KamilRosinski/autko/pcb/bom.xlsx

# | Reference | Min qty | Value | Manufacturer | Product | Package | URL | Unit price | Quantity | Total price
1 | BT1 | 1 | n/a | Keystone | 2481RB | custom | https://www.tme.eu/pl/details/keys2481rb/baterie-pojemniki-i-uchwyty/keystone/2481rb/
2 | C1, C5, C9, C11, C12, C13, C14, C16, C17, C19, C20, C22, C23, C24, C26, C27 | 16 | 100nF | Kemet | C0805C104K3RACTU | 0805 | https://www.mouser.pl/ProductDetail/80-C0805C104K3R
3 | C2 | 1 | 47µF, 16V, 40mΩ | Kemet | T521V476M016ATE040 | V | https://www.mouser.pl/ProductDetail/80-T521V476M16ATE40
4 | C3, C4 | 2 | 33µF, 25V, 25mΩ | Kemet | T521V336M025ATE025 | V | https://www.mouser.pl/ProductDetail/80-T521V336M25E25
5 | C6 | 1 | 2.2nF | Kemet | C0805C222K3RACTU | 0805 | https://www.mouser.pl/ProductDetail/80-C0805C222K3R
6 | C7 | 1 | 100pF | Kemet | C0805C101K3RACTU | 0805 | https://www.mouser.pl/ProductDetail/80-C0805C101K3RACTU
7 | C8 | 1 | 330nF | Kemet | C0805C334K3RACTU | 0805 | https://www.mouser.pl/ProductDetail/80-C0805C334K3R
8 | C10, C18 | 2 | 30pF | Kemet | C0805C300K3HACTU | 0805 | https://www.mouser.pl/ProductDetail/80-C0805C300K3HACTU
9 | C15, C21, C25 | 3 | 10uF, 25V, 60mΩ | Kemet | T521T106M025ATE060 | T | https://www.mouser.pl/ProductDetail/80-T521T106M025ATE60
10 | D1 | 1 | n/a | Diotec | SL52-3G | SMB | https://www.mouser.pl/ProductDetail/637-SL52-3G
11 | D2 | 1 | SL1A | Diotec | S1A | SMA | https://www.mouser.pl/ProductDetail/637-S1A
12 | D3, D4 | 2 | GREEN | Kingbright | APT2012LZGCK | 0805 | https://www.mouser.pl/ProductDetail/604-APT2012LZGCK
13 | D5, D6, D7, D8, D9, D10, D11 | 7 | ORANGE | Kingbright | APT2012LSECK/J4-PRV | 0805 | https://www.mouser.pl/ProductDetail/604-APT2012LSECKJ4RV
14 | D12 | 1 | BLUE | Kingbright | APT2012LVBC/D | 0805 | https://www.mouser.pl/ProductDetail/604-APT2012LVBCD
15 | F1 | 1 | 2A | Littlefuse | 1812L200/16DR | 1812 | https://www.mouser.pl/ProductDetail/576-1812L200-16DR
16 | FB1 | 1 | 220Ω | Murata | BLM21BB221SN1D | 0805 | https://www.mouser.pl/ProductDetail/81-BLM21B221S
17 | J1 | 1 | n/a | Molex | 87834-0619 | 2x3, 2.54mm | https://www.mouser.pl/ProductDetail/538-87834-0619
18 | JP1, JP2 | 2 | n/a | Molex | 10-97-7086 | 2x4, 2.54mm | https://www.mouser.pl/ProductDetail/538-10-97-7086
19 | L1 | 1 | 3.3µH | Coilcraft | MSS1260-332NLB | 4747 | https://www.mouser.pl/ProductDetail/994-MSS1260-332NLB
20 | M1, M2 | 2 | n/a | Pololu | Micro DC MP 30:1 | custom | https://www.tme.eu/pl/details/pololu-2364/silniki-dc/pololu/30-1-micro-metal-gearmotor-mp/
21 | Q1 | 1 | n/a | Vishay | Si368DY | SO-8 | https://www.mouser.pl/ProductDetail/781-SI4368DY-T1-E3
22 | R1 | 1 | 1MΩ | Vishay | CRCW08051M00FKEA | 0805 | https://www.mouser.pl/ProductDetail/71-CRCW0805-1.0M-E3
23 | R5 | 1 | 10.2kΩ, 1% | Vishay | CRCW080510K2FKEA | 0805 | https://www.mouser.pl/ProductDetail/71-CRCW0805-10.2K-E3
24 | R3 | 1 | 18kΩ | Vishay | CRCW080518K0FKEA | 0805 | https://www.mouser.pl/ProductDetail/71-CRCW080518K0FKEA
25 | R2 | 1 | 53.6kΩ, 1% | Vishay | CRCW080553K6FKEA | 0805 | https://www.mouser.pl/ProductDetail/71-CRCW080553K6FKEA
26 | R4 | 1 | 20mΩ, 0.5W, 1% | Vishay | WFC0805R0200FE66 | 0805 | https://www.mouser.pl/ProductDetail/71-WFC0805R0200FE66
27 | R6 | 1 | 5.1kΩ | Vishay | CRCW08055K10FKEA | 0805 | https://www.mouser.pl/ProductDetail/71-CRCW0805-5.1K-E3
28 | R7 | 1 | 820Ω | Vishay | CRCW0805820RFKEA | 0805 | https://www.mouser.pl/ProductDetail/71-CRCW0805-820-E3
29 | R8, R9, R12, R13, R14, R36, R37, R38, R39, R40 | 10 | 10kΩ, 0.125W, 1% | Vishay | CRCW080510K0FKEA | 0805 | https://www.mouser.pl/ProductDetail/71-CRCW0805-10K-E3
31 | R10, R11 | 2 | 1kΩ | Vishay | CRCW08051K00FKEA | 0805 | https://www.mouser.pl/ProductDetail/71-CRCW0805-1.0K-E3
32 | R23, R25, R27, R29, R31, R33, R35 | 7 | 20kΩ | Vishay | CRCW080520K0FKEA | 0805 | https://www.mouser.pl/ProductDetail/71-CRCW0805-20K-E3
33 | R15, R16, R17, R18, R19, R20, R21 | 7 | 680Ω | Vishay | CRCW0805680RFKEA | 0805 | https://www.mouser.pl/ProductDetail/71-CRCW0805680RFKEA
34 | R22, R24, R26, R28, R30, R32, R34 | 7 | 220Ω | Vishay | CRCW0805220RFKEA | 0805 | https://www.mouser.pl/ProductDetail/71-CRCW0805-220-E3
35 | R41 | 1 | 100Ω | Vishay | CRCW0805100RFKEA | 0805 | https://www.mouser.pl/ProductDetail/71-CRCW0805-100-E3
36 | R42, R43 | 2 | 330Ω | Vishay | CRCW0805330RFKEA | 0805 | https://www.mouser.pl/ProductDetail/71-CRCW0805-330-E3
37 | SW1 | 1 | n/a | Knitter-switch | MSS 3112 D | custom | https://www.tme.eu/pl/details/mss3112d/przelaczniki-suwakowe/knitter-switch/mss-3112-d/
38 | SW2, SW3 | 2 | n/a | C&K | PTS125SM43LFS | 12mm | https://www.mouser.pl/ProductDetail/611-PTS125SM43-LFS
39 | TP3, TP4, TP5 | 3 | n/a | Kaystone | 5019 | custom | https://www.mouser.pl/ProductDetail/534-5019
40 | U1 | 1 | n/a | Analog Devices | LTC3872 | SOT-23-8 | https://www.mouser.pl/ProductDetail/584-C3872ITS8-1TMPF
41 | U2 | 1 | n/a | TI | UA78M05CDCY | SOT-223-3 | https://www.mouser.pl/ProductDetail/595-UA78M33CDCYRG3
42 | U3 | 1 | n/a | Microchip | ATxmega16A4U | TQFP-44 | https://www.mouser.pl/ProductDetail/Microchip-Technology/ATXMEGA16A4U-AU?qs=HbI%2FMOA3e17KRz9K62%252BJzQ%3D%3D
43 | U4, U5, U6, U7, U8, U9, U10 | 7 | n/a | Vishay | CNY70 | custom | https://www.tme.eu/pl/en/details/cny70/pcb-photoelectric-sensors/vishay/
44 | U11 | 1 | n/a | Toshiba | TB6612FNG | SSOP24 | https://www.tme.eu/pl/en/details/tb6612fng/motor-and-pwm-drivers/toshiba/tb6612fng-o-c-8-el/
45 | U12, U13 | 2 | n/a | Nexperia | 74HC2G14GW | SOT363 | https://www.tme.eu/pl/en/details/74hc2g14gw.125/gates-inverters/nexperia/74hc2g14gw-125/
46 | U14 | 1 | n/a | Microchip | RN4678 | custom | https://www.tme.eu/pl/en/details/rn4678-v_rm113/iot-wifi-bluetooth-modules/microchip-technology/
47 | X1 | 1 | 8MHz, 20pF | Vishay | XT9S20ANA8M | HC-49/US | https://www.mouser.pl/ProductDetail/73-XT49S800-20
48 | n/a | 1 | n/a | Pololu | Metal ball caster 3/8” | custom | https://www.tme.eu/pl/details/pololu-951/akcesoria-do-robotyki-i-rc/pololu/ball-caster-with-3-8-metal-ball/
49 | n/a | 1 | n/a | Pololu | Wheel 32x7 mm black pair | custom | https://www.tme.eu/pl/details/pololu-1087/akcesoria-do-robotyki-i-rc/pololu/pololu-wheel-32x7mm-pair-black/
50 | n/a | 1 | n/a | Pololu | Bracket, black, pair | custom | https://www.tme.eu/pl/details/pololu-989/akcesoria-do-mikrosilnikow/pololu/
