KamilRosinski/autko/pcb/Autko.kicad_pcb

## KiCad design pcb/Autko.kicad_pcb (2024-03-24)

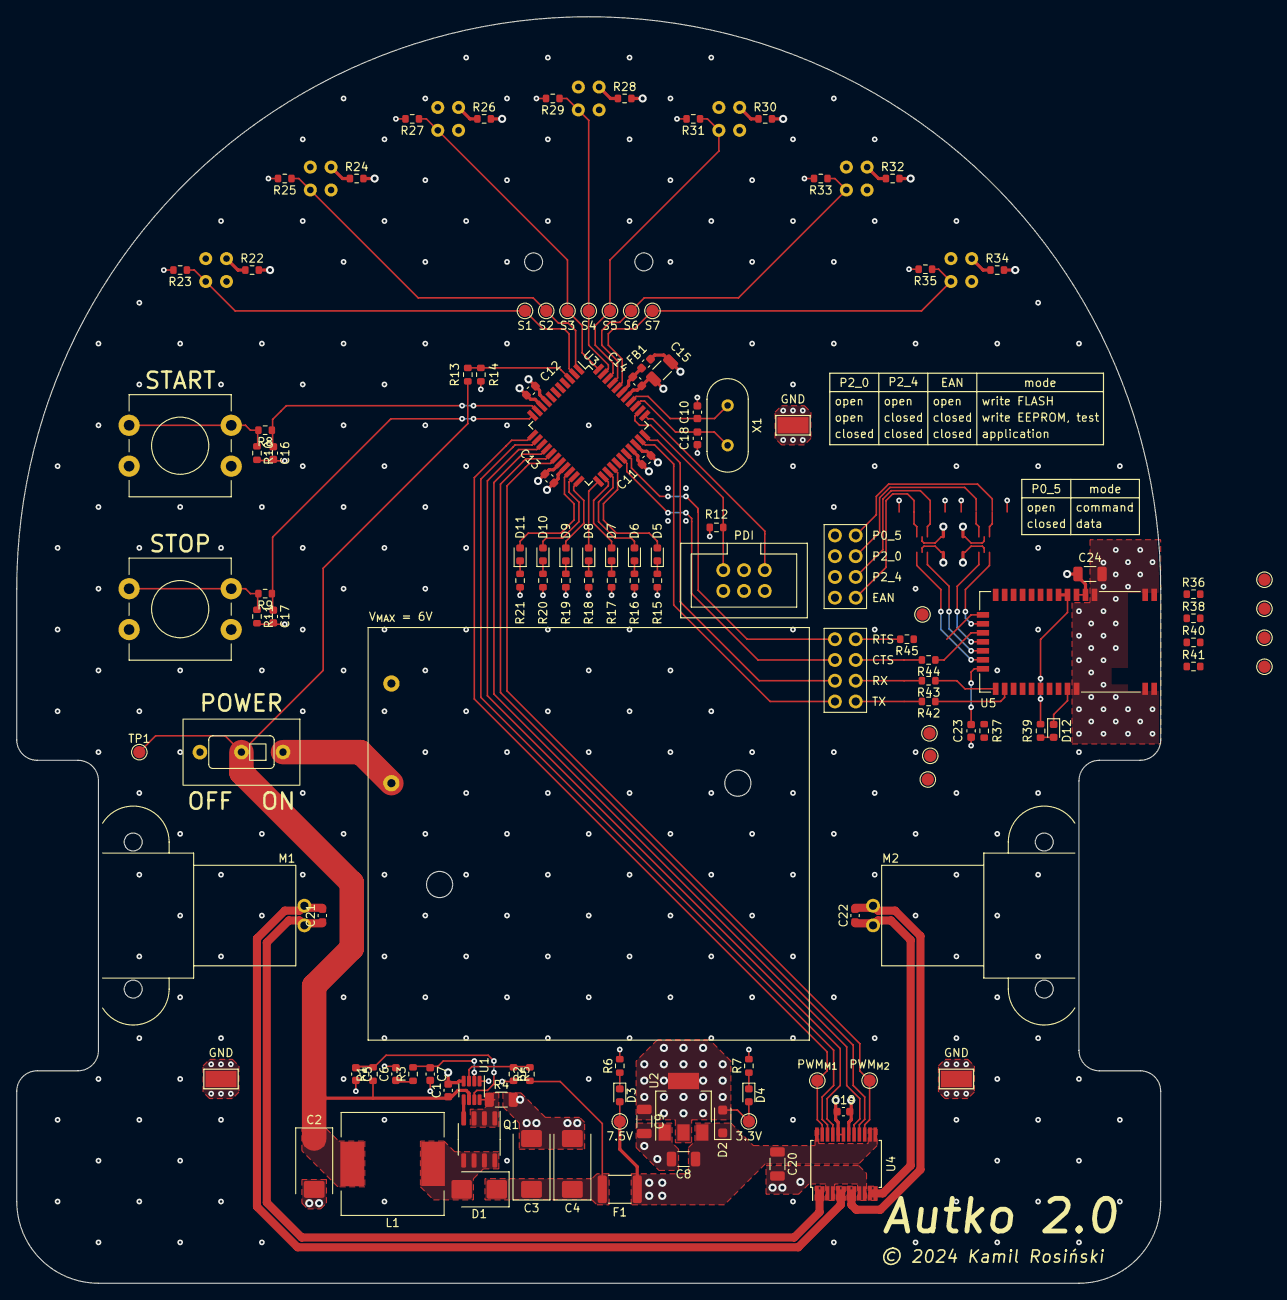
[picture p1: board Autko.kicad_pcb from above]

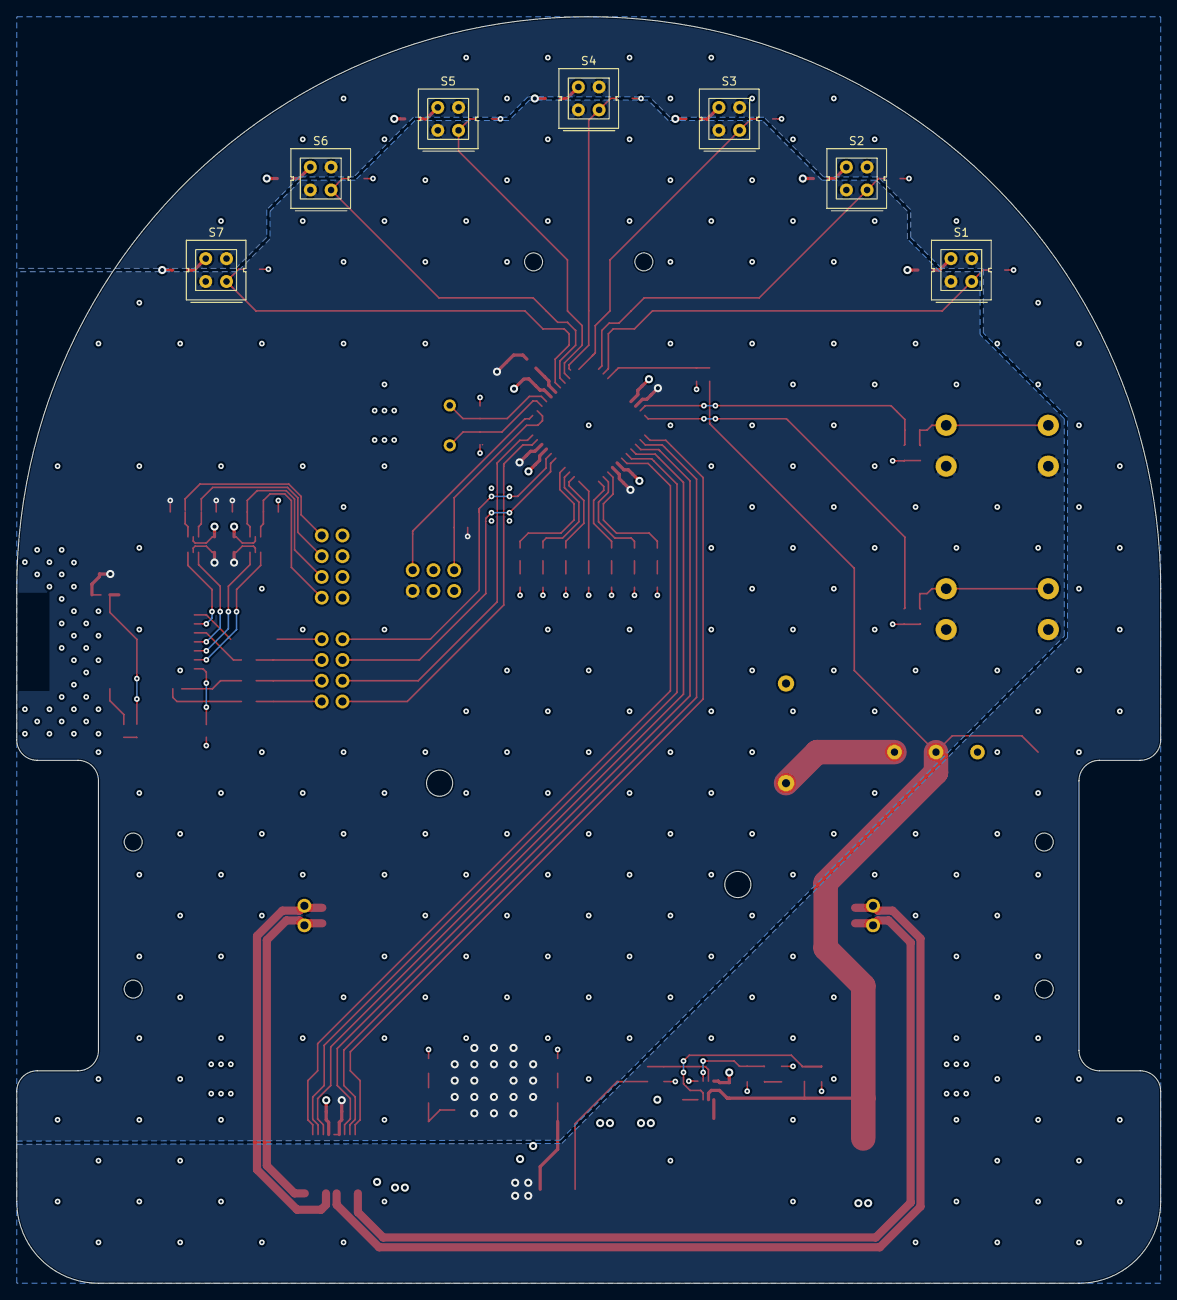
[picture p2: board Autko.kicad_pcb from below]

Board: 4 copper layers, 140.0 x 155.0 mm, 130 parts (7 on the bottom side), 87 nets.

Parts:
BT1: 4xAA; Keystone_2481RB
C1, C5, C11, C12, C13, C14, C16, C17, C19, C21, C22, C23: 100nF; C_0603_1608Metric
C2: 47uF; CP_EIA-7343-20_Kemet-V
C3, C4: 33uF; CP_EIA-7343-20_Kemet-V
C6: 2.2nF; C_0603_1608Metric
C7: 100pF; C_0603_1608Metric
C8: 1uF; C_1206_3216Metric
C9, C15, C20, C24: 10uF; C_1206_3216Metric
C10, C18: 30pF; C_0603_1608Metric
D1: SL52-3G; D_SMB
D2: SL1A; D_SOD-123F
D3, D4: GREEN; LED_0603_1608Metric
D5, D6, D7, D8, D9, D10, D11: ORANGE; LED_0603_1608Metric
D12: BLUE; LED_0603_1608Metric
F1: 2A; Fuse_1812_4532Metric
FB1: 220R; C_0603_1608Metric
J1: PDI; IDC-Header_2x03_P2.54mm_Vertical
JP1, JP2: Jumper_x4_Bridged; PinHeader_2x04_P2.54mm_Vertical
L1: 3.3uH; L_12x12mm_H6mm
M1: LEFT; Pololu_DC_micro
M2: RIGHT; Pololu_DC_micro
Q1: SO-8_3.9x4.9mm_P1.27mm
R1: 1MR; R_0603_1608Metric
R2: 53.6kR; R_0603_1608Metric
R3: 18kR; R_0603_1608Metric
R4: 20mR; R_1206_3216Metric
R5: 10.2kR; R_0603_1608Metric
R6: 5.1kR; R_0603_1608Metric
R7: 820R; R_0603_1608Metric
R8, R9, R12, R13, R14, R37: 10kR; R_0603_1608Metric
R10, R11, R42, R43, R44, R45: 1kR; R_0603_1608Metric
R15, R16, R17, R18, R19, R20, R21: 680R; R_0603_1608Metric
R22, R24, R26, R28, R30, R32, R34: 640R; R_0603_1608Metric
R23, R25, R27, R29, R31, R33, R35: 20kR; R_0603_1608Metric
R36, R38, R39, R40, R41: 100R; R_0603_1608Metric
S1, S2, S3, S4, S5, S6, S7: CNY70; Vishay_CNY70
SW1: POWER; Knitter-Switch_MSS_3112_D
SW2: START; 12mm_tact_switch
SW3: STOP; 12mm_tact_switch
TP1, TP2, TP6, TP7, TP8, TP9, TP10, TP11, TP12, TP13, TP14, TP15, TP16, TP17, TP18, TP19, TP20, TP21, TP22, TP23: TestPoint; TestPoint_Pad_D1.5mm
TP3, TP4, TP5: TestPoint; TestPoint_Keystone_5019_Minature
U1: LTC3872; SOT-23-8
U2: TLV761; SOT-223-3_TabPin2
U3: ATxmega16A4U-A; TQFP-44_10x10mm_P0.8mm
U4: TB6612FNG; SSOP-24_5.3x8.2mm_P0.65mm
U5: RN4678
X1: 8MHz; Crystal_HC49-4H_Vertical

Connections:
+3.3V: C9.1, C11.1, C12.1, C13.1, C15.1, C19.1, C24.1, D2.2 (A), D4.2 (A), FB1.2, J1.2, R12.1, S1.3 (C), S2.3 (C), S3.3 (C), S4.3 (C), S5.3 (C), S6.3 (C), S7.3 (C), SW2.2, SW3.2, TP6.1, U2.2 (VO), U3.9 (VCC), U3.19 (VCC), U3.31 (VCC), U4.19 (STBY), U4.20 (VCC), U5.4 (BAT_IN), U5.5 (SW_BTN)
+7.5V: C8.1, C20.1, D2.1 (K), D3.2 (A), F1.2, S1.1 (A), S2.1 (A), S3.1 (A), S4.1 (A), S5.1 (A), S6.1 (A), S7.1 (A), TP2.1, U2.3 (VI), U4.13 (VM2), U4.14 (VM3), U4.24 (VM1)
+BATT: C1.1, C2.1, L1.1, R1.1, R13.1, SW1.1 (A), TP1.1, U1.6 (VIN)
/Bluetooth/BT_3V3: JP1.1, R37.1, R39.2, U5.6 (LDO33_O), U5.7 (VDD_IO)
/Bluetooth/CTS: JP2.8, U3.29 (PE1)
/Bluetooth/EAN: R36.2, TP16.1, U5.20 (EAN)
/Bluetooth/P0_5: R41.2, TP19.1, U5.16 (P0_5)
/Bluetooth/P2_0: R40.2, TP18.1, U5.18 (P2_0)
/Bluetooth/P2_4: R38.2, TP17.1, U5.19 (P2_4)
/Bluetooth/RTS: JP2.6, U3.28 (PE0)
/Bluetooth/RX: JP2.4, U3.33 (PE3)
/Bluetooth/TX: JP2.2, U3.32 (PE2)
/Bluetooth/~RST: C23.1, R37.2, U5.21 (~RST)
/Line sensors/SENSOR1: R23.1, S1.4 (E), TP7.1, U3.2 (PA6)
/Line sensors/SENSOR2: R25.1, S2.4 (E), TP8.1, U3.1 (PA5)
/Line sensors/SENSOR3: R27.1, S3.4 (E), TP9.1, U3.44 (PA4)
/Line sensors/SENSOR4: R29.1, S4.4 (E), TP10.1, U3.43 (PA3)
/Line sensors/SENSOR5: R31.1, S5.4 (E), TP11.1, U3.42 (PA2)
/Line sensors/SENSOR6: R33.1, S6.4 (E), TP12.1, U3.41 (PA1)
/Line sensors/SENSOR7: R35.1, S7.4 (E), TP13.1, U3.40 (AREFA/PA0)
/Microcontroller/BTN_START: C16.1, R8.1, U3.10 (PC0)
/Microcontroller/BTN_STOP: C17.1, R9.1, U3.11 (PC1)
/Microcontroller/LED1: D5.2 (A), U3.26 (PD6)
/Microcontroller/LED2: D6.2 (A), U3.25 (PD5)
/Microcontroller/LED3: D7.2 (A), U3.24 (PD4)
/Microcontroller/LED4: D8.2 (A), U3.23 (PD3)
/Microcontroller/LED5: D9.2 (A), U3.22 (PD2)
/Microcontroller/LED6: D10.2 (A), U3.21 (PD1)
/Microcontroller/LED7: D11.2 (A), U3.20 (PD0)
/Microcontroller/M1_IN1: U3.14 (PC4), U4.21 (AIN1)
/Microcontroller/M1_IN2: U3.13 (PC3), U4.22 (AIN2)
/Microcontroller/M1_PWM: TP14.1, U3.12 (PC2), U4.23 (PWMA)
/Microcontroller/M2_IN1: U3.15 (PC5), U4.17 (BIN1)
/Microcontroller/M2_IN2: U3.16 (PC6), U4.16 (BIN2)
/Microcontroller/M2_PWM: TP15.1, U3.17 (PC7), U4.15 (PWMB)
/Microcontroller/PDI_CLK: J1.5, R12.2, U3.35 (~RESET/PDI_CLK)
/Microcontroller/PDI_DATA: J1.1, U3.34 (PDI_DATA)
/Microcontroller/XTAL1: C10.1, U3.37 (PR1/XTAL1), X1.2
/Microcontroller/XTAL2: C18.1, U3.36 (PR0/XTAL2), X1.1
GND: BT1.2 (-), C1.2, C2.2, C3.2, C4.2, C5.2, C6.2, C7.2, C8.2, C9.2, C10.2, C11.2, C12.2, C13.2, C14.2, C15.2, C16.2, C17.2, C18.2, C19.2, C20.2, C23.2, C24.2, J1.6, JP1.3, JP1.5, JP1.7, R4.2, R5.2, R6.2, R7.2, R10.2, R11.2, R14.2, R15.2, R16.2, R17.2, R18.2, R19.2, R20.2, R21.2, R22.2, R23.2, R24.2, R25.2, R26.2, R27.2, R28.2, R29.2, R30.2, R31.2, R32.2, R33.2, R34.2, R35.2, TP3.1, TP4.1, TP5.1, U1.1 (IPRG), U1.4 (GND), U2.1 (GND), U3.8 (GND), U3.18 (GND), U3.30 (GND), U3.38 (GND), U4.3 (PGND1), U4.4 (PGND1), U4.9 (PGND2), U4.10 (PGND2), U4.18 (GND), U5.1 (GND), U5.2 (GND), U5.3 (GND), U5.31 (GND), U5.32 (GND), U5.33 (GND)
unnamed: BT1.1 (+), SW1.2 (B)
unnamed: C6.1, R3.1
unnamed: D1.2 (A), L1.2, Q1.5 (D), Q1.6 (D), Q1.7 (D), Q1.8 (D)
unnamed: C3.1, C4.1, D1.1 (K), F1.1, R2.1
unnamed: D3.1 (K), R6.1
unnamed: D4.1 (K), R7.1
unnamed: D5.1 (K), R15.1
unnamed: D6.1 (K), R16.1
unnamed: D7.1 (K), R17.1
unnamed: D8.1 (K), R18.1
unnamed: D9.1 (K), R19.1
unnamed: D10.1 (K), R20.1
unnamed: D11.1 (K), R21.1
unnamed: D12.2 (A), R39.1
unnamed: D12.1 (K), U5.30 (LED)
unnamed: JP1.2, R36.1
unnamed: JP1.4, R38.1
unnamed: JP1.6, R40.1
unnamed: JP1.8, R41.1
unnamed: JP2.1, R42.2
unnamed: JP2.3, R43.2
unnamed: JP2.5, R44.2
unnamed: JP2.7, R45.2
unnamed: C21.1, M1.1 (+), U4.1 (AO1), U4.2 (AO1)
unnamed: C21.2, M1.2 (-), U4.5 (AO2), U4.6 (AO2)
unnamed: C22.1, M2.2 (+), U4.11 (BO1), U4.12 (BO1)
unnamed: C22.2, M2.1 (-), U4.7 (BO2), U4.8 (BO2)
unnamed: Q1.4 (G), U1.5 (NGATE)
unnamed: R8.2, R10.1, SW2.1
unnamed: R9.2, R11.1, SW3.1
unnamed: R22.1, S1.2 (K)
unnamed: R24.1, S2.2 (K)
unnamed: R26.1, S3.2 (K)
unnamed: R28.1, S4.2 (K)
unnamed: R30.1, S5.2 (K)
unnamed: R32.1, S6.2 (K)
unnamed: R34.1, S7.2 (K)
unnamed: R2.2, R5.1, U1.3 (FB)
unnamed: C7.1, R3.2, U1.2 (ITH)
unnamed: C5.1, R1.2, U1.7 (RUN/SS)
unnamed: Q1.1 (S), Q1.2 (S), Q1.3 (S), R4.1, U1.8 (SW)
unnamed: C14.1, FB1.1, U3.39 (AVCC)
unnamed: R13.2, R14.1, U3.3 (PA7)
unnamed: R44.1, TP22.1, U5.17 (P0_0/RTS)
unnamed: R45.1, TP23.1, U5.15 (P1_7/CTS)
unnamed: R43.1, TP21.1, U5.22 (UART_RX)
unnamed: R42.1, TP20.1, U5.23 (UART_TX)
