KamilRosinski/autko/(commit log)

2023-04-02 Initial commit - empty project
    [autko.kicad_pcb, autko.kicad_sch]
2023-04-02 Hierarchical sheets
    [autko.kicad_sch, bluetooth.kicad_sch, line_sensors.kicad_sch, microcontroller.kicad_sch, motors.kicad_sch, power_supply.kicad_sch]
2023-04-03 Power supply initial schematic
    [power_supply.kicad_sch]
2023-04-05 Power supply voltage regulators
    [power_supply.kicad_sch]
2023-04-05 Power supply schematic beautified
    [power_supply.kicad_sch]
2023-04-05 Initial microcontroller schematic
    [autko.kicad_sch, microcontroller.kicad_sch]
2023-04-06 Uppercase project name
    [Autko.kicad_pcb, Autko.kicad_sch, Bluetooth.kicad_sch, Line_sensors.kicad_sch, Microcontroller.kicad_sch, Motors.kicad_sch, Power_supply.kicad_sch]
2023-04-06 Microcontroller schematic
    [Microcontroller.kicad_sch]
2023-04-07 Motors schematic
    [Motors.kicad_sch]
2023-04-09 Ferrite bead added to uC AVCC pin
    [Microcontroller.kicad_sch]
2023-04-09 10uF removed from uC power supply
    [Microcontroller.kicad_sch]
2023-04-26 Line sensors
    [Autko.kicad_sch, Line_sensors.kicad_sch]
2023-04-26 Bluetooth initial schematic
    [Bluetooth.kicad_sch]
2023-04-30 Bluetooth schematic
    [Bluetooth.kicad_sch]
2023-05-02 Annotate schematics
    [Bluetooth.kicad_sch, Line_sensors.kicad_sch, Microcontroller.kicad_sch, Motors.kicad_sch, Power_supply.kicad_sch]
2023-05-02 ERC fixes
    [Bluetooth.kicad_sch, Microcontroller.kicad_sch, Power_supply.kicad_sch]
2023-05-08 Move KiCad project to dedicated folder
    [Autko.kicad_pcb, Autko.kicad_sch, Bluetooth.kicad_sch, Line_sensors.kicad_sch, Microcontroller.kicad_sch, Motors.kicad_sch, Power_supply.kicad_sch]
2023-05-11 Added RN4678 symbol & footprint
2023-05-14 Pololu micro DC motor footprint added
2023-05-14 Pololu ball caster footprint added
2023-05-14 Battery holder footprint added
2023-05-14 Bluetooth RN4870 replaced with RN4678
    [Bluetooth.kicad_sch]
2023-05-14 Schematic annotated
    [Bluetooth.kicad_sch, Microcontroller.kicad_sch, Power_supply.kicad_sch]
2023-05-31 [pcb] Test point added
    [Bluetooth.kicad_sch, Line_sensors.kicad_sch, Motors.kicad_sch, Power_supply.kicad_sch]
2023-06-04 [pcb] Schematic clean-up
    [Bluetooth.kicad_sch, Line_sensors.kicad_sch, Microcontroller.kicad_sch, Motors.kicad_sch, Power_supply.kicad_sch]
2023-06-05 [pcb] Footprints assigned
    [Bluetooth.kicad_sch, Line_sensors.kicad_sch, Microcontroller.kicad_sch, Motors.kicad_sch, Power_supply.kicad_sch]
2023-06-05 [pcb] Missing connection
    [Microcontroller.kicad_sch]
2023-06-08 [pcb] Add 100R resistor for BT status LED
    [Bluetooth.kicad_sch, Microcontroller.kicad_sch]
2023-07-07 [app] Bugfixes on BT devices list
2023-09-19 [pcb] Rework schematic for ATxmega16A4U
    [Autko.kicad_sch, Bluetooth.kicad_sch, Line_sensors.kicad_sch, Microcontroller.kicad_sch, Motors.kicad_sch, Power_supply.kicad_sch]
2023-09-21 Power switch footprint and initial pcb
    [Autko.kicad_pcb, Bluetooth.kicad_sch, Line_sensors.kicad_sch, Microcontroller.kicad_sch, Motors.kicad_sch]
2023-09-21 [pcb] Power switch footprint assigned
    [Power_supply.kicad_sch]
2023-09-21 [pcb] Motor footprint fix
2023-09-23 [pcb] Initial layout
    [Autko.kicad_pcb, Microcontroller.kicad_sch]
2023-09-30 [pcb] Line sensors placed
    [Autko.kicad_pcb, Microcontroller.kicad_sch]
2023-10-02 [pcb] Trying to minimize number of vias
    [Autko.kicad_pcb, Bluetooth.kicad_sch, Microcontroller.kicad_sch]
2023-10-05 [pcb] Route PDI and UART
    [Autko.kicad_pcb]
2023-10-05 [pcb] Rotate uC by 45 deg
    [Autko.kicad_pcb, Microcontroller.kicad_sch]
2023-10-06 [pcb] Remove unnecessary capacitors
    [Autko.kicad_pcb, Microcontroller.kicad_sch, Motors.kicad_sch]
2023-10-07 [pcb] Replace 5V with 3.3V
    [Microcontroller.kicad_sch]
2023-10-10 [pcb] BT routing
    [Autko.kicad_pcb, Bluetooth.kicad_sch, Line_sensors.kicad_sch, Microcontroller.kicad_sch, Motors.kicad_sch]
2023-10-10 [pcb] Ball caster added to PCB
    [Autko.kicad_pcb]
2023-10-21 [pcb] Line sensors routed
    [Autko.kicad_pcb, Line_sensors.kicad_sch]
2023-10-21 [pcb] Buttons routed
    [Autko.kicad_pcb, Microcontroller.kicad_sch]
2023-10-30 [pcb] Boost converter routing
    [Autko.kicad_pcb, Microcontroller.kicad_sch, Power_supply.kicad_sch]
2023-11-01 [pcb] Voltage regulator and motor driver
    [Autko.kicad_pcb]
2023-11-01 [pcb] Bluetooth ground plane
    [Autko.kicad_pcb]
2023-11-11 [pcb] Some power routing
    [Autko.kicad_pcb, Motors.kicad_sch, Power_supply.kicad_sch]
2023-11-15 [pcb] Alternative power routing
    [Autko.kicad_pcb]
2023-12-27 [pcb] 4 layer PCB
    [Autko.kicad_pcb, Autko.kicad_sch, Bluetooth.kicad_sch, Line_sensors.kicad_sch, Microcontroller.kicad_sch, Motors.kicad_sch, Power_supply.kicad_sch]
2023-12-28 [pcb] BT config rework
    [Autko.kicad_pcb, Bluetooth.kicad_sch, Line_sensors.kicad_sch, Microcontroller.kicad_sch, Motors.kicad_sch]
2023-12-29 [pcb] Almost ready
    [Autko.kicad_pcb, Bluetooth.kicad_sch]
2023-12-31 [pcb] Final touches
    [Autko.kicad_pcb]
2024-01-14 [pcb] More final touches, UART test ponts added.
    [Autko.kicad_pcb, Autko.kicad_sch, Bluetooth.kicad_sch, Line_sensors.kicad_sch, Microcontroller.kicad_sch, Motors.kicad_sch, Power_supply.kicad_sch]
2024-01-14 [pcb] Mark high-precision resistors
    [Microcontroller.kicad_sch, Power_supply.kicad_sch]
2024-01-14 [pcb] 10uF capacitor changed from A to T package
    [Autko.kicad_pcb, Bluetooth.kicad_sch, Microcontroller.kicad_sch, Motors.kicad_sch]
2024-01-21 [pcb] ERC/DRC checks
    [Autko.kicad_pcb, Autko.kicad_sch, Line_sensors.kicad_sch, Power_supply.kicad_sch]
2024-01-21 [pcb] BOM added
    [bom.xlsx]
2024-01-21 [pcb] ERC fixes
    [Line_sensors.kicad_sch, Microcontroller.kicad_sch, Motors.kicad_sch, Power_supply.kicad_sch]
2024-01-23 [pcb] Swap voltage divider resistors
    [bom.xlsx]
2024-01-25 [pcb] Fix typos in boost converter calculations
    [Power_supply.kicad_sch]
2024-01-27 [pcb] Change Schottky diode
    [Autko.kicad_pcb, Power_supply.kicad_sch, bom.xlsx]
2024-01-27 [pcb] Inductor upgrade, boost converter clean-up
    [Autko.kicad_pcb, Power_supply.kicad_sch, bom.xlsx]
2024-01-28 [pcb] Line sensors changed to pull-down and re-routed
    [Autko.kicad_pcb, Bluetooth.kicad_sch, Line_sensors.kicad_sch, Motors.kicad_sch]
2024-01-28 [pcb] Max voltage label added
    [Autko.kicad_pcb]
2024-01-28 [pcb] Move label
    [Autko.kicad_pcb]
2024-01-29 [pcb] Motors resized to 24mm
    [Autko.kicad_pcb]
2024-02-03 [pcb] Voltage regulator changed to TLV761
    [Autko.kicad_pcb, Bluetooth.kicad_sch, Microcontroller.kicad_sch, Power_supply.kicad_sch]
2024-02-03 [pcb] Add missing vias, fix power traces
    [Autko.kicad_pcb]
2024-02-25 [pcb] Test points reduced to 1.5mm; flow control series resistors added
    [Autko.kicad_pcb, Bluetooth.kicad_sch, Line_sensors.kicad_sch, Motors.kicad_sch, Power_supply.kicad_sch]
2024-02-25 [pcb] Rename line sensors to S1..S7
    [Autko.kicad_pcb, Bluetooth.kicad_sch, Line_sensors.kicad_sch, Motors.kicad_sch]
2024-02-25 [pcb] Fix power plane edge
    [Autko.kicad_pcb]
2024-03-12 [bt] Configuration commands
    [RN4678_configuration_commands.txt]
2024-03-16 [bt] Configuration commands updated
    [RN4678_configuration_commands.txt]
2024-03-17 [pcb] Bluetooth configuration simplified
    [Autko.kicad_pcb, Bluetooth.kicad_sch]
2024-03-23 [pcb] Assign smaller footprints
    [Bluetooth.kicad_sch, Line_sensors.kicad_sch, Microcontroller.kicad_sch, Motors.kicad_sch, Power_supply.kicad_sch]
2024-03-24 [pcb] Start reworking pcb with 0603 components
    [Autko.kicad_pcb, Bluetooth.kicad_sch, Microcontroller.kicad_sch]
2024-03-24 [bt] Disable BT status strings
    [RN4678_configuration_commands.txt]
