KamilRosinski/autko/(notices)

Notices in the files:
pcb/Autko.kicad_pcb:
© 2024 Kamil Rosiński
